cturek/E155-Autofeeder/README.md

# E155 Fall 2022: Pet Autofeeder
An example final project portfolio for MicroPs
