cturek/E155-Autofeeder/cad/SLDPRT/autofeed_magic.SLDPRT

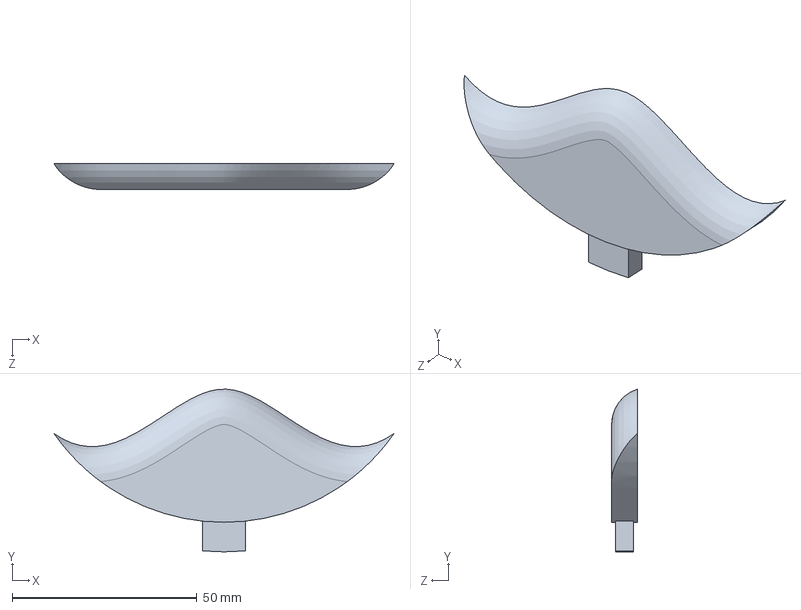
[picture p16: CAD file, 2022-12-09]
cad/SLDPRT/autofeed_magic.SLDPRT
91.9 x 44.0 x 7.00 mm
