cturek/E155-Autofeeder/cad/SLDPRT/autofeed_container.SLDPRT

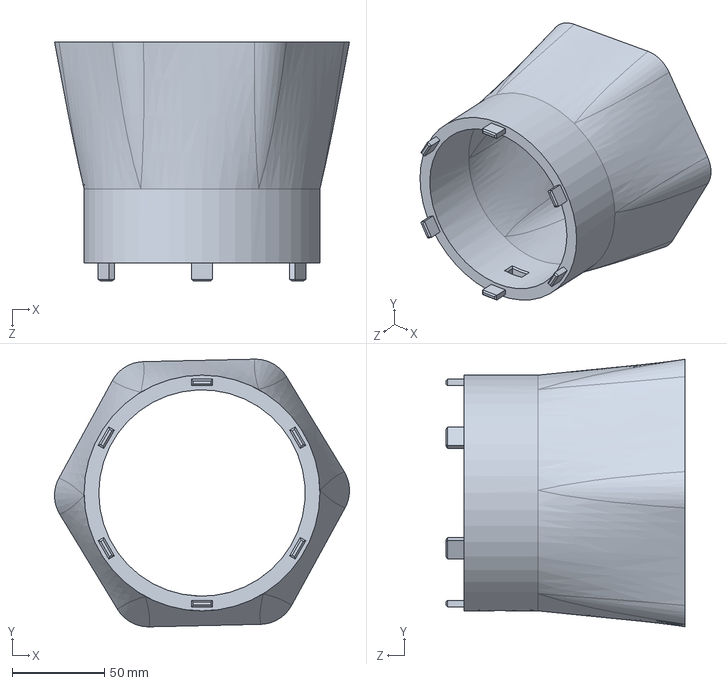
[picture p17: CAD file, 2022-12-09]
cad/SLDPRT/autofeed_container.SLDPRT
160.1 x 145.3 x 130.0 mm
