cturek/E155-Autofeeder/cad/SLDPRT/autofeed_disc.SLDPRT

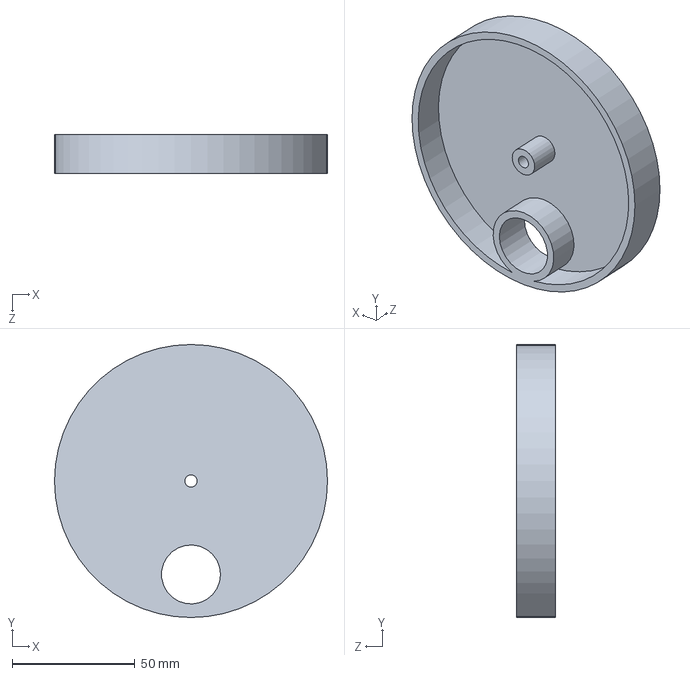
[picture p18: CAD file, 2022-12-09]
cad/SLDPRT/autofeed_disc.SLDPRT
111.0 x 111.0 x 16.0 mm
