cturek/E155-Autofeeder/cad/SLDPRT/autofeed_tower.SLDPRT

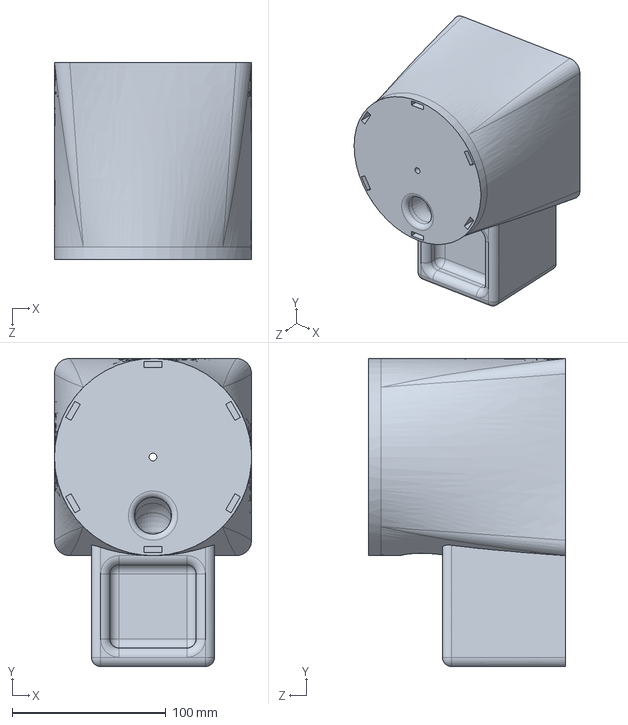
[picture p19: CAD file, 2022-12-09]
cad/SLDPRT/autofeed_tower.SLDPRT
128.0 x 200.0 x 128.0 mm
