cturek/E155-Autofeeder/(list of files, cad)

Other CAD files:
cad/STL/autofeed_container.STL
cad/STL/autofeed_disc.STL
cad/STL/autofeed_magic.STL
cad/STL/autofeed_tower.STL
