cturek/E155-Autofeeder/(commit log)

2022-12-08 following brake tutorial
2022-12-09 Added fpga schematic, added abstract
2022-12-09 Added Solidworks images to website. Fixed MCU schematic.
2022-12-09 Removed extraneous references page. Changed housing file to see if difference is made.
2022-12-09 Added FPGA src code and cad files
    [autofeed_container.SLDPRT, autofeed_container.STL, autofeed_disc.SLDPRT, autofeed_disc.STL, autofeed_magic.SLDPRT, autofeed_magic.STL, autofeed_tower.SLDPRT, autofeed_tower.STL]
